Pawlax/Sterownik_rolety_zigbee/bom.pdf

bom

Page 1

Ref. | Wartość | Footprint | Ilość | Opis | Dostawca | Link | Koszt j.(1szt) | Cena (1 PCB) | Koszt j.(10szt) | Cena (10 PCB) | Koszt j.(100szt) | Cena (100 PCB)
C1 | 4.7uF | Capacitor_SMD:C_0603_1608Metric_Pad1.08x0.95mm_HandSolder | 1 Unpolarized capacitor | Mouser | 0.65 zł | 0.65 zł | 0.20 zł | 1.98 zł | 0.17 zł | 16.80 zł
C2,C3,C6,C8,C9,C10,C12,C17 | 100nF | Capacitor_SMD:C_0603_1608Metric_Pad1.08x0.95mm_HandSolder | 8 Unpolarized capacitor | Zaikostore | 0.04 zł | 0.33 zł | 0.04 zł | 3.28 zł | 0.04 zł | 32.80 zł
C4 | 470nF | Capacitor_SMD:C_0603_1608Metric_Pad1.08x0.95mm_HandSolder | 1 Unpolarized capacitor | Mouser | 0.57 zł | 0.57 zł | 0.23 zł | 2.28 zł | 0.15 zł | 14.60 zł
C5,C16 | 1uF | Capacitor_SMD:C_0603_1608Metric_Pad1.08x0.95mm_HandSolder | 2 Unpolarized capacitor | DigiKey | 0.41 zł | 0.82 zł | 0.09 zł | 1.82 zł | 0.06 zł | 12.40 zł
C7 | 10uF | Capacitor_SMD:C_0603_1608Metric_Pad1.08x0.95mm_HandSolder | 1 Unpolarized capacitor | DigiKey | 0.41 zł | 0.41 zł | 0.13 zł | 1.30 zł | 0.09 zł | 8.90 zł
C11 | 0.8pF | Capacitor_SMD:C_0603_1608Metric_Pad1.08x0.95mm_HandSolder | 1 Unpolarized capacitor | Mouser | 0.697 | 0.70 zł | 0.452 | 4.52 zł | 0.228 | 22.80 zł
C13,C14 | 16pF | Capacitor_SMD:C_0603_1608Metric_Pad1.08x0.95mm_HandSolder | 2 Unpolarized capacitor | Esaler Electronic | 0.12 zł | 0.24 zł | 0.12 zł | 2.40 zł | 0.12 zł | 24.00 zł
C15 | 0.3pF | Capacitor_SMD:C_0603_1608Metric_Pad1.08x0.95mm_HandSolder | 1 Unpolarized capacitor | DigiKey | 0.60 zł | 0.60 zł | 0.35 zł | 3.50 zł | 0.25 zł | 25.00 zł
D1,D2 | LED_Red | LED_SMD:LED_0603_1608Metric_Pad1.05x0.95mm_HandSolder | 2 Light emitting diode, filled shape | Mouser | 0.86 zł | 1.72 zł | 0.40 zł | 8.00 zł | 0.20 zł | 40.40 zł
FL1 | DLF162500LT-5028A1 | Sterownik_roletyLibrary:DLF162500LT5028A1 | 1 Signal Conditioning LTCC LOW PASS FLTR 2400-2500MHz | Mouser | 1.96 zł | 1.96 zł | 1.85 zł | 18.50 zł | 1.74 zł | 174.00 zł
IC1 | STM32WBA54KGU6 | Sterownik_roletyLibrary:QFN50P500X500X60-33N-D | 1 Wireless Arm Cortex-M33 Trust Zone MCU with Zigbee | Mouser | 23.05 zł | 23.05 zł | 15.05 zł | 150.50 zł | 14.09 zł | 1,409.00 zł
J1 | 282836-5 | Sterownik_roletyLibrary:2828365 | 1 Header | Electrical Characteristics: Operating Voltage 300 VAC | | Mouser | 6.71 zł | 6.71 zł | 5.20 zł | 52.00 zł | 4.64 zł | 464.00 zł
J2 | 1725669 | Sterownik_roletyLibrary:1725669 | 1 PCB terminal block, nominal current: 6 A, rated voltage (III/2): 160 V | TME | 4.31 zł | 4.31 zł | 4.31 zł | 43.10 zł | 3.42 zł | 342.00 zł
J3 | 53398-0567 | Sterownik_roletyLibrary:533980567 | 1 Headers & Wire Housings 1.25 WTB WAFER 5Ckt | Mouser | 4.86 zł | 4.86 zł | 4.29 zł | 42.90 zł | 3.80 zł | 380.00 zł
L1 | 2.7nH | Inductor_SMD:L_0603_1608Metric_Pad1.05x0.95mm_HandSolder | 1 Inductor | Mouser | 0.41 zł | 0.41 zł | 0.15 zł | 1.51 zł | 0.15 zł | 15.10 zł
Q1,Q2 | BT136-600 | Package_TO_SOT_THT:TO-220-3_Vertical | 2 4A RMS, 500V Off-State Voltage, Triac, TO-220 | AVT | 1.80 zł | 3.60 zł | 1.80 zł | 36.00 zł | 1.80 zł | 360.00 zł
Q3,Q4 | MOC3032SR2M | Package_DIP:DIP-6_W8.89mm_SMDSocket_LongPads | 2 Optotriac | Mouser | 2.07 zł | 4.14 zł | 1.95 zł | 39.00 zł | 1.91 zł | 382.00 zł
R1,R2,R3,R4 | 180R | Resistor_SMD:R_0603_1608Metric_Pad0.98x0.95mm_HandSolder | 4 Resistor | Mouser | 0.46 zł | 1.86 zł | 0.05 zł | 2.08 zł | 0.01 zł | 5.20 zł
R5,R6 | 330R | Resistor_SMD:R_0603_1608Metric_Pad0.98x0.95mm_HandSolder | 2 Resistor | TME | 0.37 zł | 0.73 zł | 0.04 zł | 0.79 zł | 0.02 zł | 4.66 zł
U1,U2 | LTV-817 | Package_DIP:DIP-4_W7.62mm | 2 DC Optocoupler, Vce 35V, CTR 50%, DIP-4 | Mouser | 1.72 zł | 3.44 zł | 1.01 zł | 20.20 zł | 0.50 zł | 100.60 zł
PS1 | RAC05-3.3SK | Converter_ACDC:Converter_ACDC_RECOM_RAC05-xxSK_THT | 1 5W Single Output EMC Class B 3.3V 1515mA | Mouser | 46.87 zł | 46.87 zł | 46.18 zł | 461.80 zł | 40.38 zł | 4,038.00 zł
Y1 | TXC 7R-32.000MEEV-T | Sterownik_roletyLibrary:TXC 7R-32.000MEEV-T | 1 Four pin crystal, GND on pins 2 and 4 | Digikey | 2.52 zł | 2.52 zł | 2.18 zł | 21.80 zł | 1.97 zł | 197.00 zł
| | | | | | | 1 PCB | | 10 PCB | | 100 PCB
| | | | | | Łącznie | Za sztukę | Łącznie | Za sztukę | Łącznie | Za sztukę
| | | | | Łączny koszt kompnentów | 110.50 zł | 110.50 zł | 919.26 zł | 91.93 zł | 8,069.26 zł | 80.69 zł
Produkcja PCB | 8.29 zł | 8.29 zł | 20.71 zł | 2.07 zł | 81.98 zł | 0.82 zł
| | | | | Suma | 118.79 zł | 118.79 zł | 939.97 zł | 94.00 zł | 8,151.24 zł | 81.51 zł

link (https://www.mouser.pl/ProductDetail/Murata-Electronics/GRM188R61E475KE11D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)
link (https://www.zaikostore.com/zaikostore/en/stockDetail?stockID=st64811696)
link (https://www.mouser.pl/ProductDetail/Murata-Electronics/GRM188R71E474KA12D?qs=5VWgUag8BO05DbKPNL84bA%3D%3D)
link (https://www.digikey.com/en/products/detail/walsin-technology-corporation/0603B105K250CT/14837019?curr=usd)
link (https://www.digikey.com/en/products/detail/walsin-technology-corporation/0603X106M6R3CT/14830826?curr=usd)
link (https://www.mouser.pl/ProductDetail/Murata-Electronics/GCM1885C2AR80BA16J)
link (https://www.elecsaler.com/product/murata/gcm1885c2a160fa16d-11236865)
link (https://www.digikey.bg/en/products/detail/murata-electronics/GJM1555C1HR30WB01D/2593245)
link (https://www.mouser.pl/ProductDetail/Lite-On/LTST-C190KRKT?qs=kAD5fFa1n5VY3YYNWPC1Fg%3D%3D)
link (https://www.mouser.pl/ProductDetail/TDK/DLF162500LT-5028A1?qs=U%2FZX79kHR%2FlwIbAISCs3qA%3D%3D)
link (https://www.mouser.pl/ProductDetail/STMicroelectronics/STM32WBA54KGU6?qs=Z%252BL2brAPG1JAa6VTqSppyg%3D%3D)
link (https://www.mouser.pl/ProductDetail/TE-Connectivity/282836-5?qs=A%252Bip%252BNCYi6PWM9nOrDokEg%3D%3D)
link (https://www.tme.eu/pl/details/mpt0.5_3-2.54/listwy-zaciskowe-do-druku/phoenix-contact/1725669/?gad_source=1)
link (https://www.mouser.pl/ProductDetail/Molex/53398-0567?qs=YbyaSBbY%2FzyzhOKGMMuQvw%3D%3D)
link (https://www.mouser.pl/ProductDetail/KEMET/L0603C2N7SRMST?qs=v1sh8PPj49gJHURlIJB4QA%3D%3D)
link (https://sklep.avt.pl/pl/products/triak-bt136-600-kt207-500-164756.html)
link (https://eu.mouser.com/ProductDetail/onsemi-Fairchild/MOC3032SR2M?qs=Q3c8oR7VdSoN0Us1kztB%2FQ%3D%3D)
link (https://www.mouser.pl/ProductDetail/Walsin/WR06X1800FTL?qs=t1sE%252BOcWp5ujA9Z8%2FbuwQg%3D%3D)
link (https://www.tme.eu/pl/en/details/wr06x331jtl/smd-resistors/walsin/wr06x331-jtl/)
link (https://www.mouser.pl/ProductDetail/Lite-On/LTV-817?qs=N6LLV8I65%252BeGRLHZiOxD6A%3D%3D)
link (https://www.mouser.pl/ProductDetail/RECOM-Power/RAC05-3.3SK?qs=BZBei1rCqCCc2PDPqoMlxw%3D%3D)
link (https://www.digikey.gr/en/products/detail/txc-corporation/7R-32-000MEEV-T/12314103)
A | B | C | D | E | F | G | H | I | J | K | L | M
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
