Pawlax/Sterownik_rolety_zigbee/sterownik_rolety_Zigbee.pdf

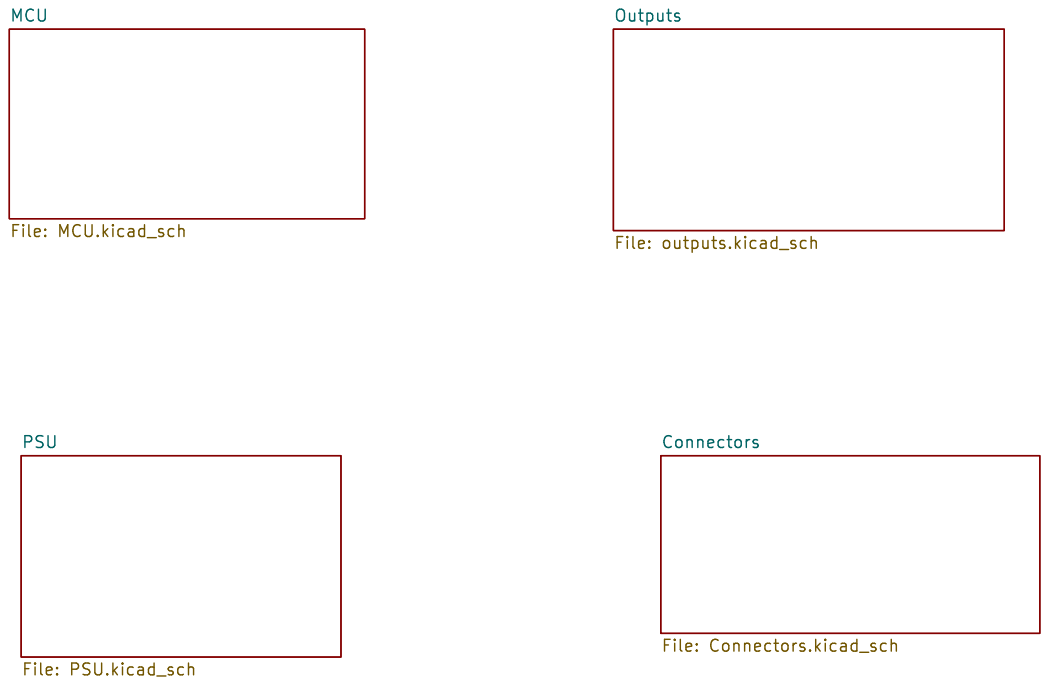
[picture p1: page 1]

Id: 1/5 Title: sterownik rolety z þÿkomunikacj zigbee

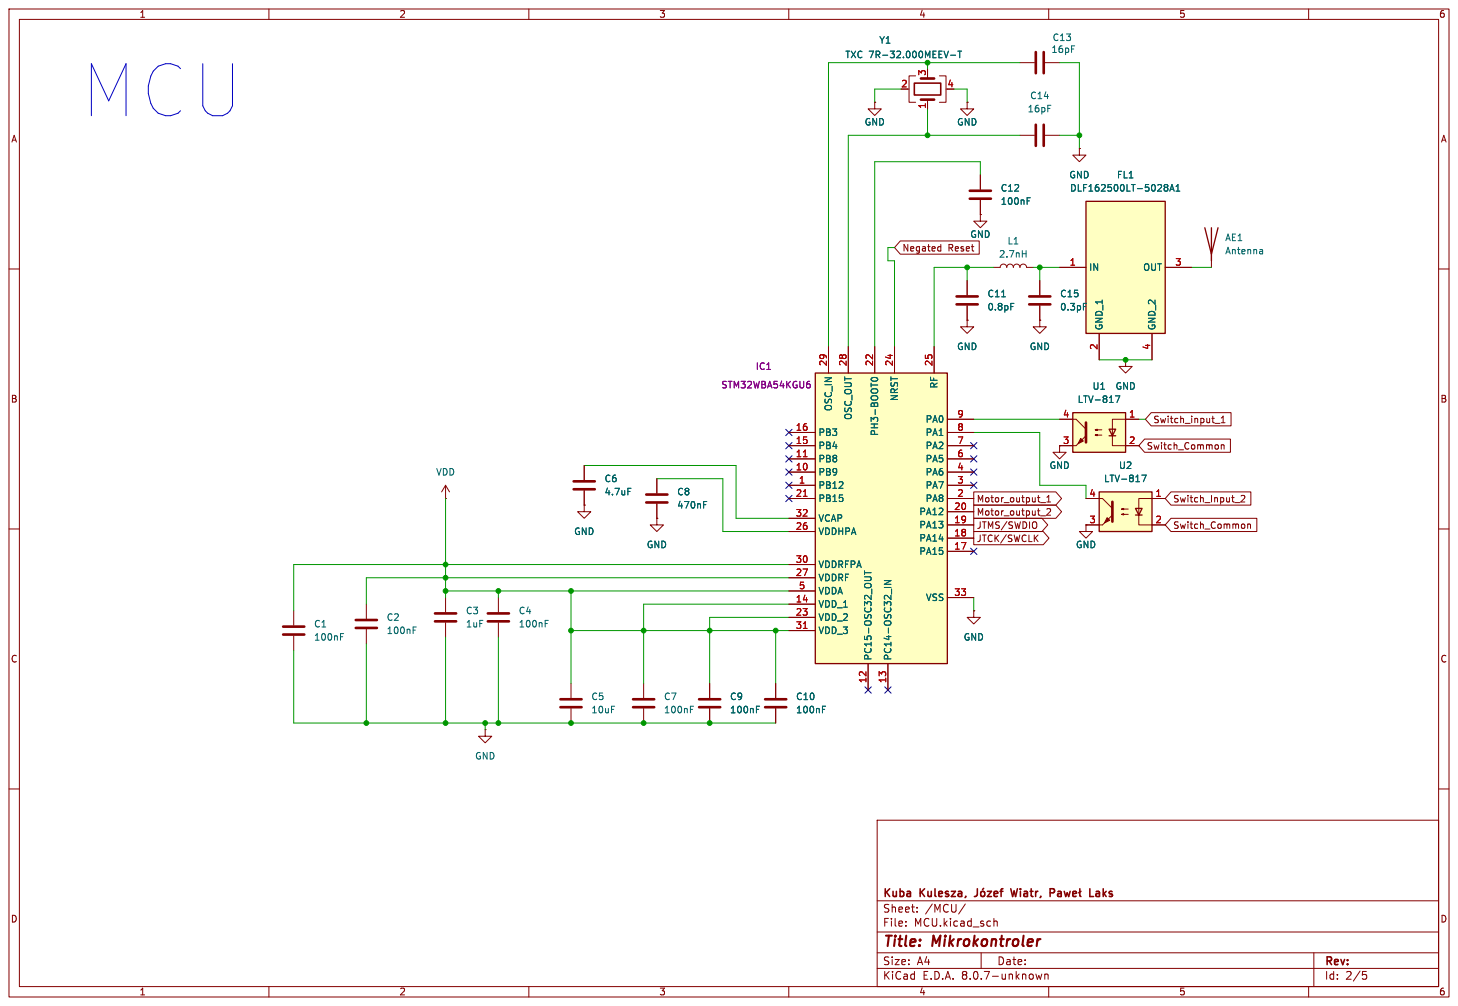
[picture p2: page 2]

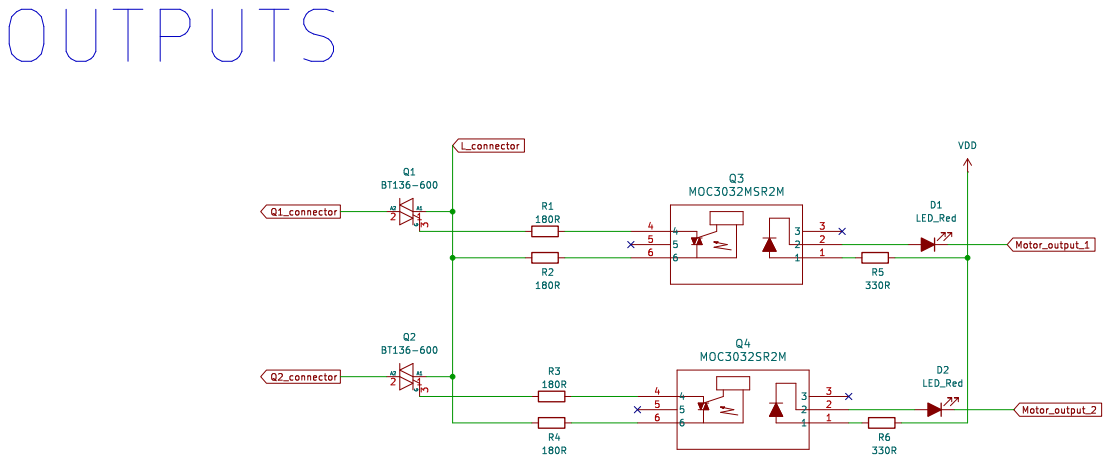
[picture p3: page 3]

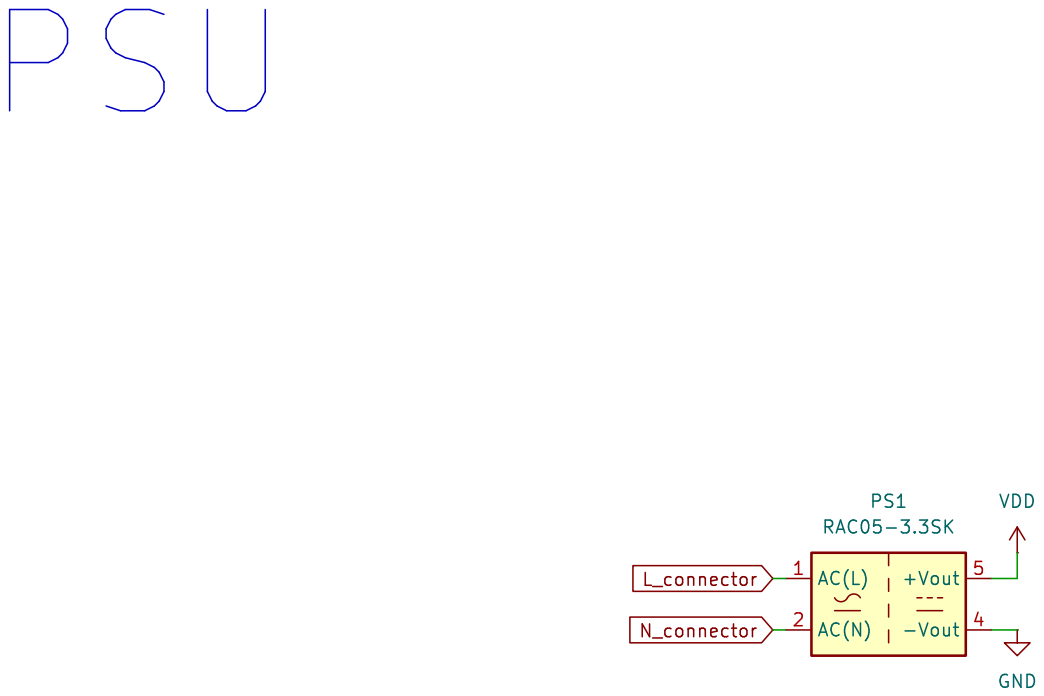
[picture p4: page 4]

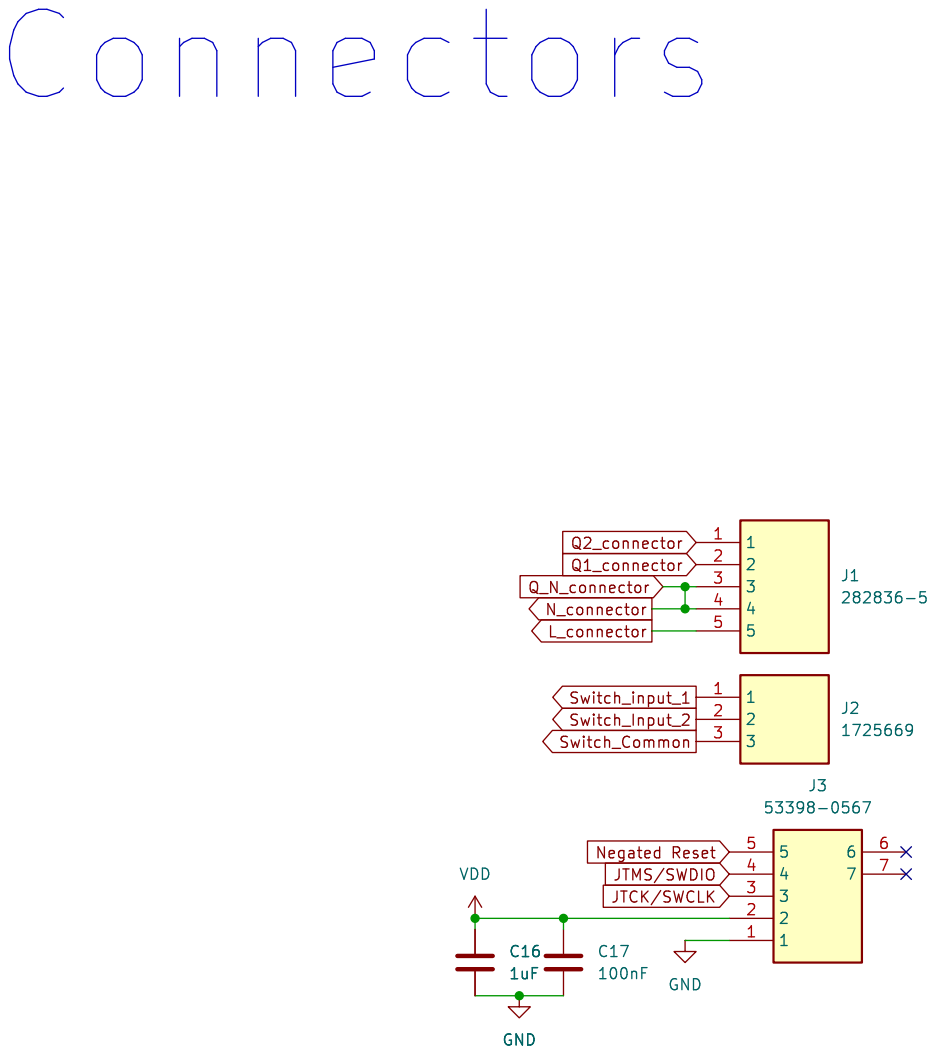
[picture p5: page 5]

L_connector Switch_Common Switch_input_1 Q_N_connector Negated Reset JTMS/SWDIO
