Pawlax/Sterownik_rolety_zigbee/sterownik_rolety_Zigbee.kicad_pcb

## KiCad design sterownik_rolety_Zigbee.kicad_pcb (2025-01-05)

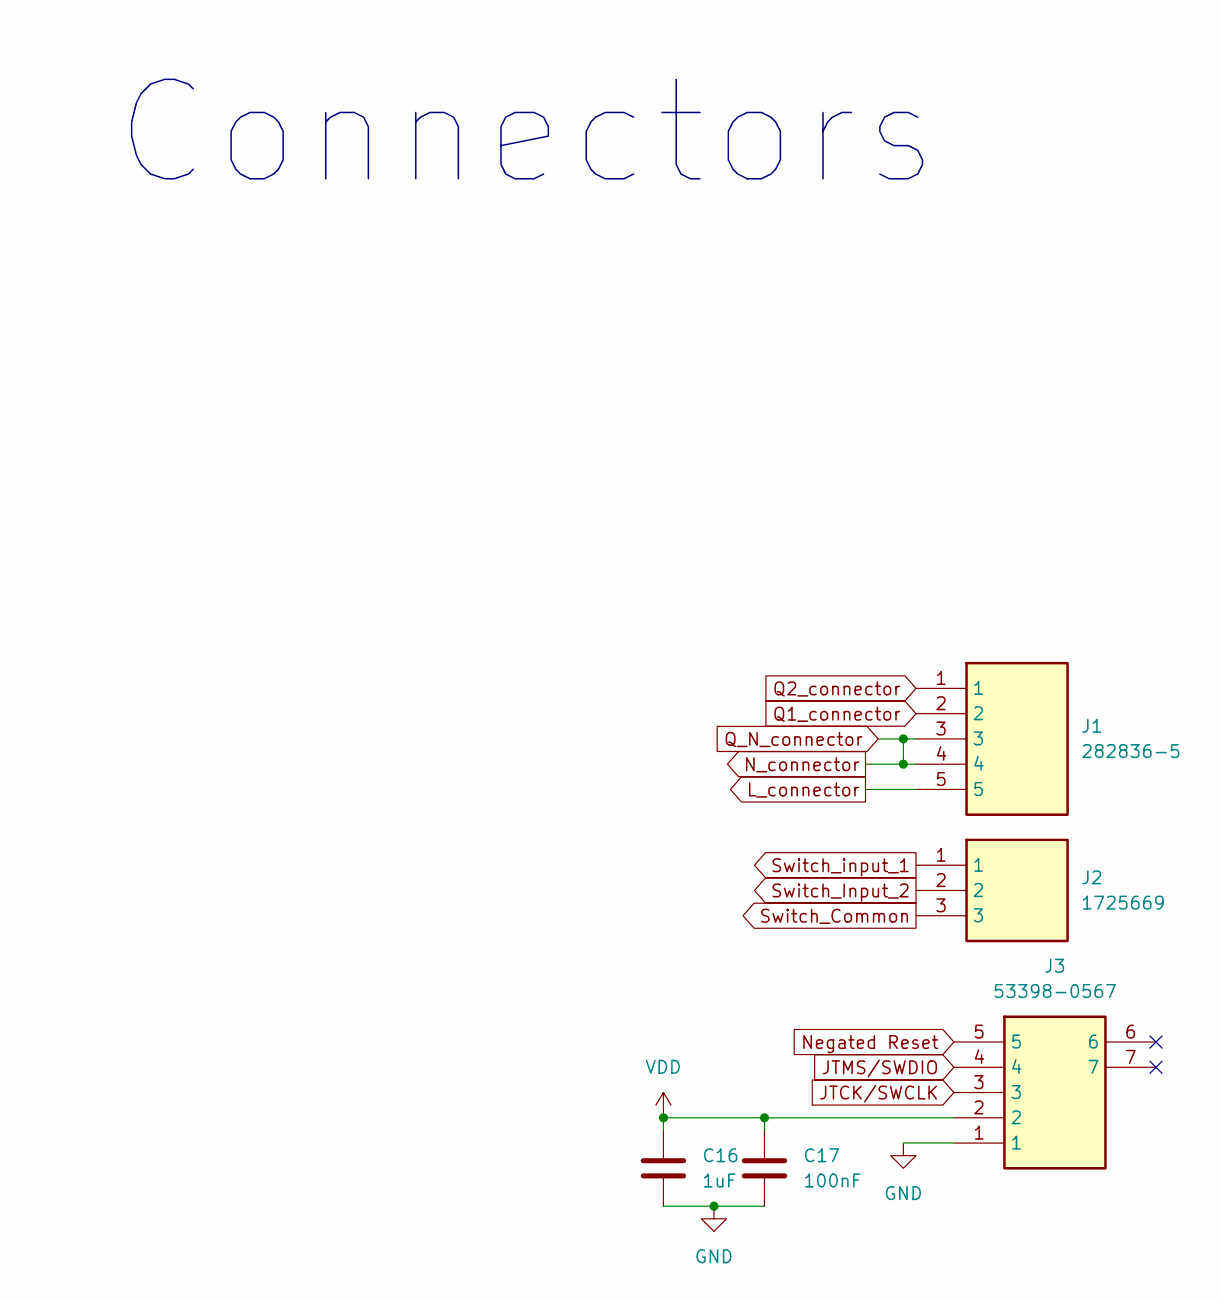
[picture p6: schematic Connectors.kicad_sch, Złącza]

Parts:
C16: 1uF; C_0603_1608Metric_Pad1.08x0.95mm_HandSolder
C17: 100nF; C_0603_1608Metric_Pad1.08x0.95mm_HandSolder
J1: 282836-5; 2828365; Mouser Part Number 571-2828365
J2: 1725669; Mouser Part Number 651-1725669
J3: 53398-0567; 533980567; Mouser Part Number 538-53398-0567

Connections:
GND: C16.2, C17.2, J3.1; also elsewhere on the board
JTCK/SWCLK: J3.3; also elsewhere on the board
JTMS/SWDIO: J3.4; also elsewhere on the board
L_connector: J1.5; also elsewhere on the board
N_connector: J1.3, J1.4; also elsewhere on the board
Negated Reset: J3.5; also elsewhere on the board
Q1_connector: J1.2; also elsewhere on the board
Q2_connector: J1.1; also elsewhere on the board
Switch_Common: J2.3; also elsewhere on the board
Switch_Input_2: J2.2; also elsewhere on the board
Switch_input_1: J2.1; also elsewhere on the board
VDD: C16.1, C17.1, J3.2; also elsewhere on the board

Notes on the sheet:
Connectors

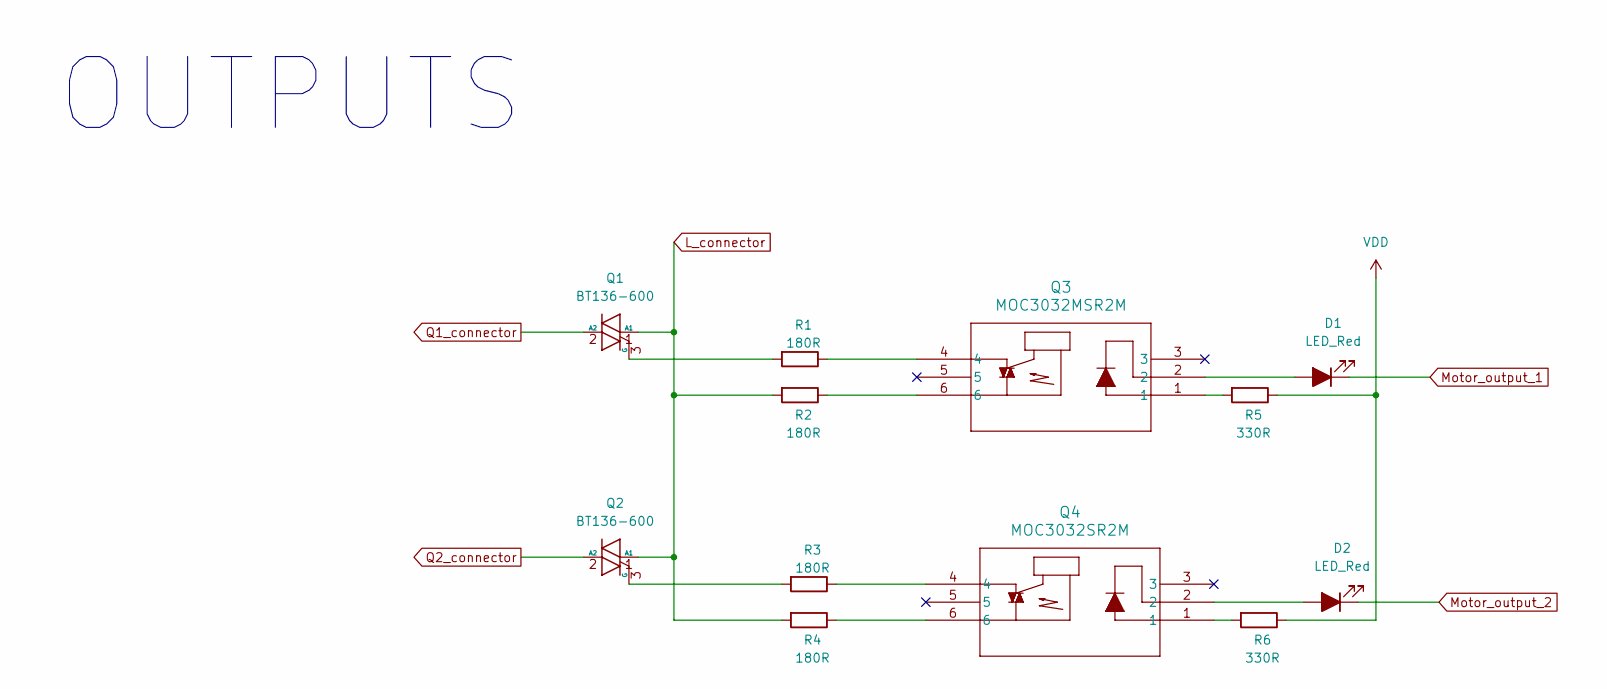
[picture p7: schematic outputs.kicad_sch, Wyjścia]

Parts:
D1, D2: LED_Red; LED_0603_1608Metric_Pad1.05x0.95mm_HandSolder
Q1, Q2: BT136-600; TO-220-3_Vertical
Q3: MOC3032MSR2M; DIP-6_W8.89mm_SMDSocket_LongPads
Q4: MOC3032SR2M; DIP-6_W8.89mm_SMDSocket_LongPads
R1, R2, R3, R4: 180R; R_0603_1608Metric_Pad0.98x0.95mm_HandSolder
R5, R6: 330R; R_0603_1608Metric_Pad0.98x0.95mm_HandSolder

Connections:
L_connector: Q1.1 (A1), Q2.1 (A1), R2.2, R4.2; also elsewhere on the board
Motor_output_1: D1.1 (K); also elsewhere on the board
Motor_output_2: D2.1 (K); also elsewhere on the board
unnamed: D1.2 (A), Q3.2
unnamed: D2.2 (A), Q4.2
unnamed: Q1.3 (G), R1.2
unnamed: Q2.3 (G), R3.2
unnamed: Q3.1, R5.2
unnamed: Q3.4, R1.1
unnamed: Q3.6, R2.1
unnamed: Q4.1, R6.2
unnamed: Q4.4, R3.1
unnamed: Q4.6, R4.1
Q1_connector: Q1.2 (A2); also elsewhere on the board
Q2_connector: Q2.2 (A2); also elsewhere on the board
VDD: R5.1, R6.1; also elsewhere on the board

Notes on the sheet:
OUTPUTS

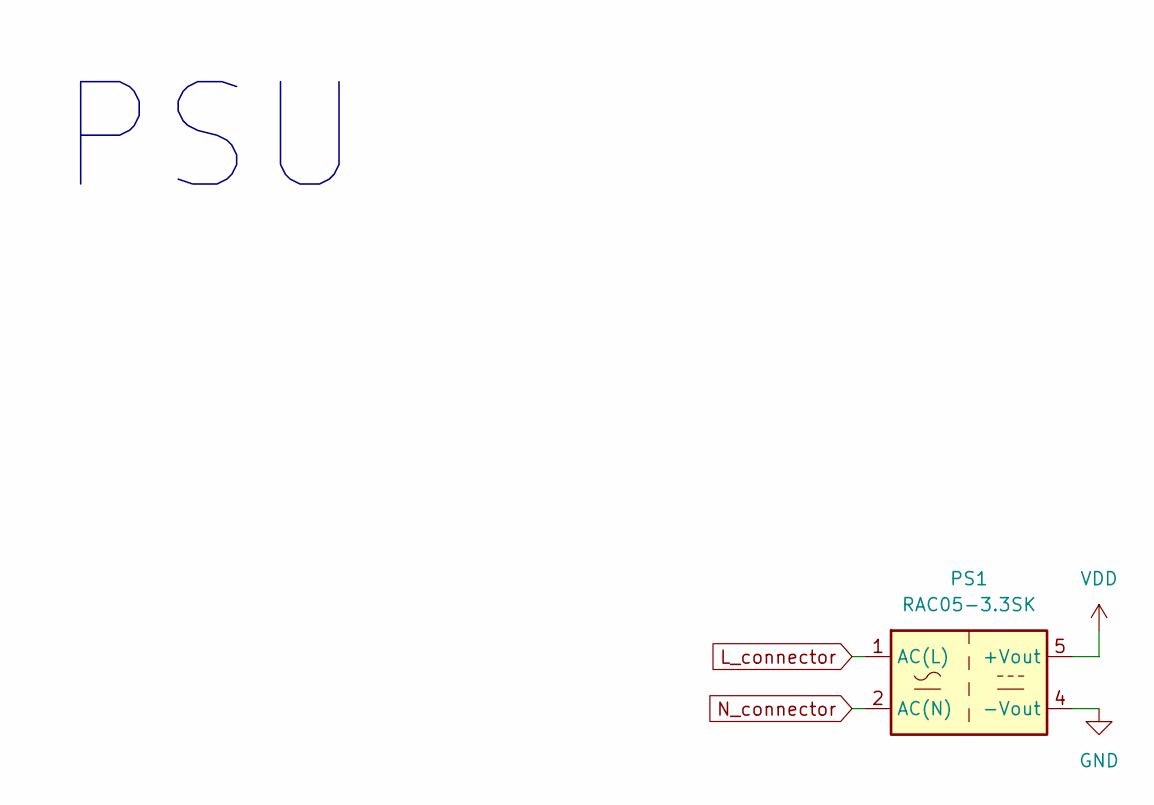
[picture p8: schematic PSU.kicad_sch, Zasilanie]

Parts:
PS1: RAC05-3.3SK; Converter_ACDC_RECOM_RAC05-xxSK_THT

Connections:
GND: PS1.4 (-Vout); also elsewhere on the board
L_connector: PS1.1 (AC(L)); also elsewhere on the board
N_connector: PS1.2 (AC(N)); also elsewhere on the board
VDD: PS1.5 (+Vout); also elsewhere on the board

Notes on the sheet:
PSU

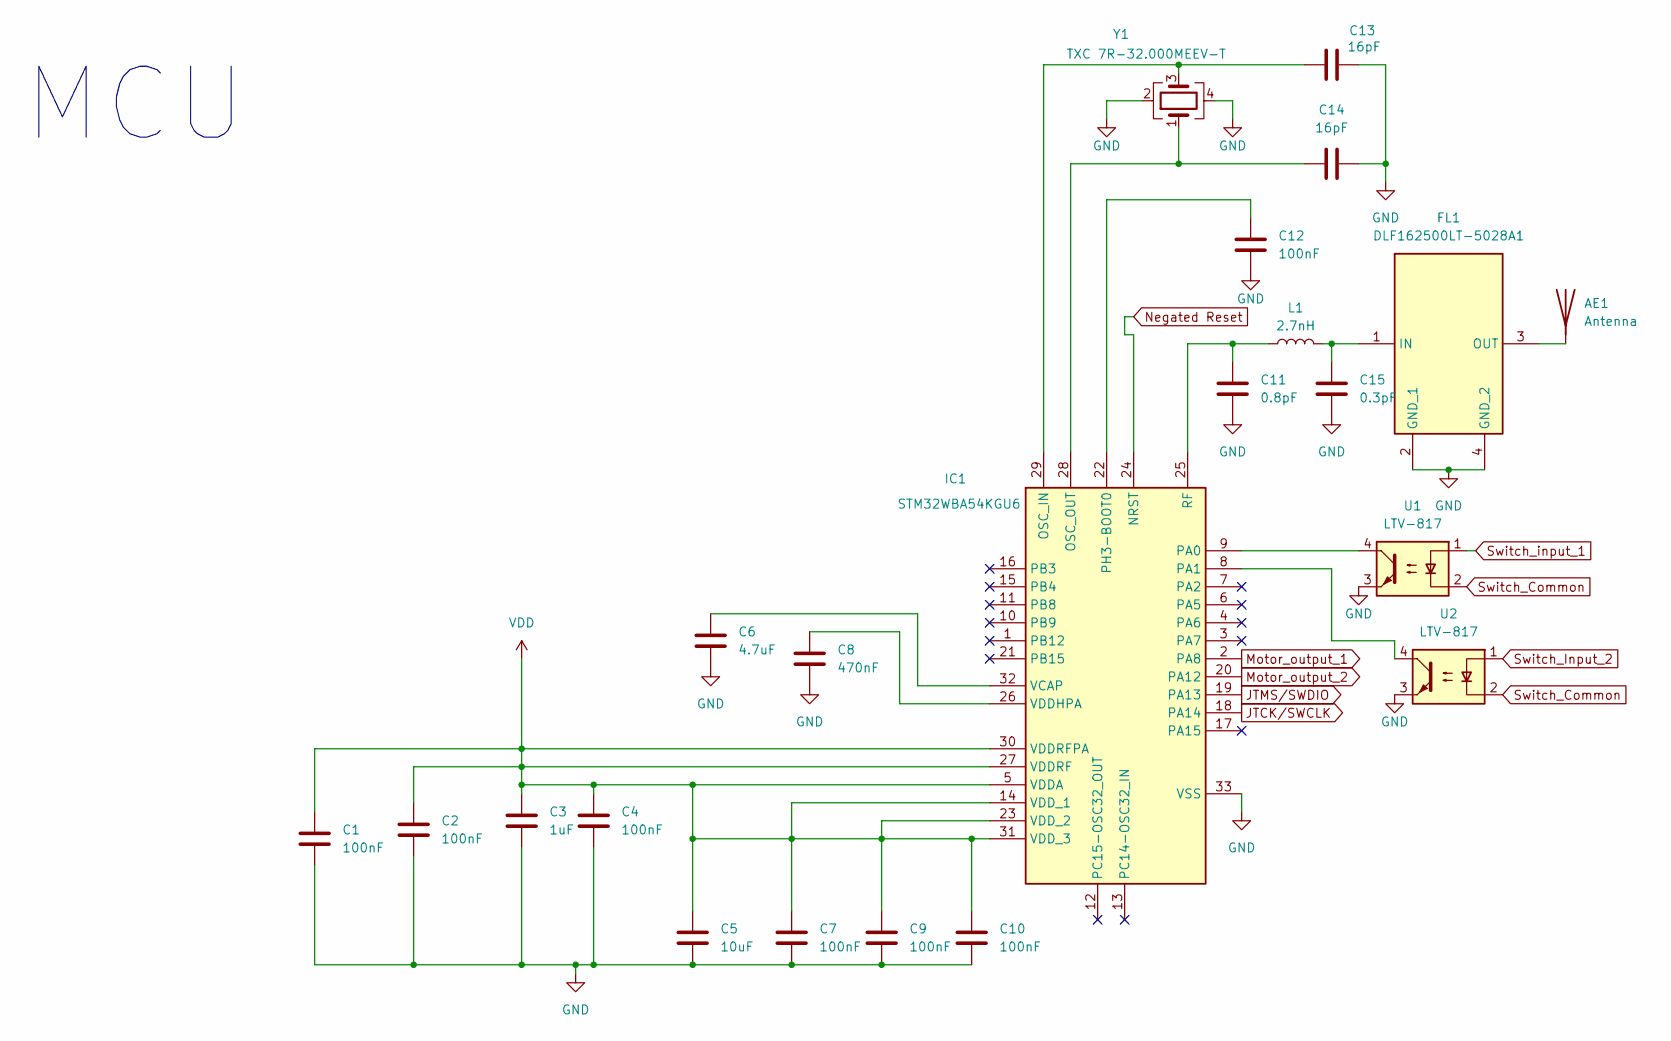
[picture p9: schematic MCU.kicad_sch, Mikrokontroler]

Parts:
AE1: Antenna; Texas_SWRA117D_2.4GHz_Right
C1, C2, C4, C7, C9, C10, C12: 100nF; C_0603_1608Metric_Pad1.08x0.95mm_HandSolder
C3: 1uF; C_0603_1608Metric_Pad1.08x0.95mm_HandSolder
C5: 10uF; C_0603_1608Metric_Pad1.08x0.95mm_HandSolder
C6: 4.7uF; C_0603_1608Metric_Pad1.08x0.95mm_HandSolder
C8: 470nF; C_0603_1608Metric_Pad1.08x0.95mm_HandSolder
C11: 0.8pF; C_0603_1608Metric_Pad1.08x0.95mm_HandSolder
C13, C14: 16pF; C_0603_1608Metric_Pad1.08x0.95mm_HandSolder
C15: 0.3pF; C_0603_1608Metric_Pad1.08x0.95mm_HandSolder
FL1: DLF162500LT-5028A1; DLF162500LT5028A1; Mouser Part Number 810-DLF16250LT5028A1
IC1: STM32WBA54KGU6; QFN50P500X500X60-33N-D; Mouser Part Number 511-STM32WBA54KGU6
L1: 2.7nH; L_0603_1608Metric_Pad1.05x0.95mm_HandSolder
U1, U2: LTV-817; SMDIP-4_W9.53mm
Y1: TXC 7R-32.000MEEV-T

Connections:
GND: C1.2, C2.2, C3.2, C4.2, C5.2, C6.2, C7.2, C8.2, C9.2, C10.2, C11.2, C12.2, C13.1, C14.1, C15.2, FL1.2 (GND_1), FL1.4 (GND_2), IC1.33 (VSS), U1.3, U2.3, Y1.2, Y1.4; also elsewhere on the board
JTCK/SWCLK: IC1.18 (PA14); also elsewhere on the board
JTMS/SWDIO: IC1.19 (PA13); also elsewhere on the board
Motor_output_1: IC1.2 (PA8); also elsewhere on the board
Motor_output_2: IC1.20 (PA12); also elsewhere on the board
Negated Reset: IC1.24 (NRST); also elsewhere on the board
unnamed: AE1.1 (A), FL1.3 (OUT)
unnamed: C15.1, FL1.1 (IN), L1.2
unnamed: C13.2, IC1.29 (OSC_IN), Y1.3
unnamed: C14.2, IC1.28 (OSC_OUT), Y1.1
unnamed: IC1.9 (PA0), U1.4
unnamed: IC1.8 (PA1), U2.4
unnamed: C12.1, IC1.22 (PH3-BOOT0)
unnamed: C11.1, IC1.25 (RF), L1.1
unnamed: C6.1, IC1.32 (VCAP)
unnamed: C8.1, IC1.26 (VDDHPA)
Switch_Common: U1.2, U2.2; also elsewhere on the board
Switch_Input_2: U2.1; also elsewhere on the board
Switch_input_1: U1.1; also elsewhere on the board
VDD: C1.1, C2.1, C3.1, C4.1, C5.1, C7.1, C9.1, C10.1, IC1.5 (VDDA), IC1.14 (VDD_1), IC1.23 (VDD_2), IC1.27 (VDDRF), IC1.30 (VDDRFPA), IC1.31 (VDD_3); also elsewhere on the board

Notes on the sheet:
MCU

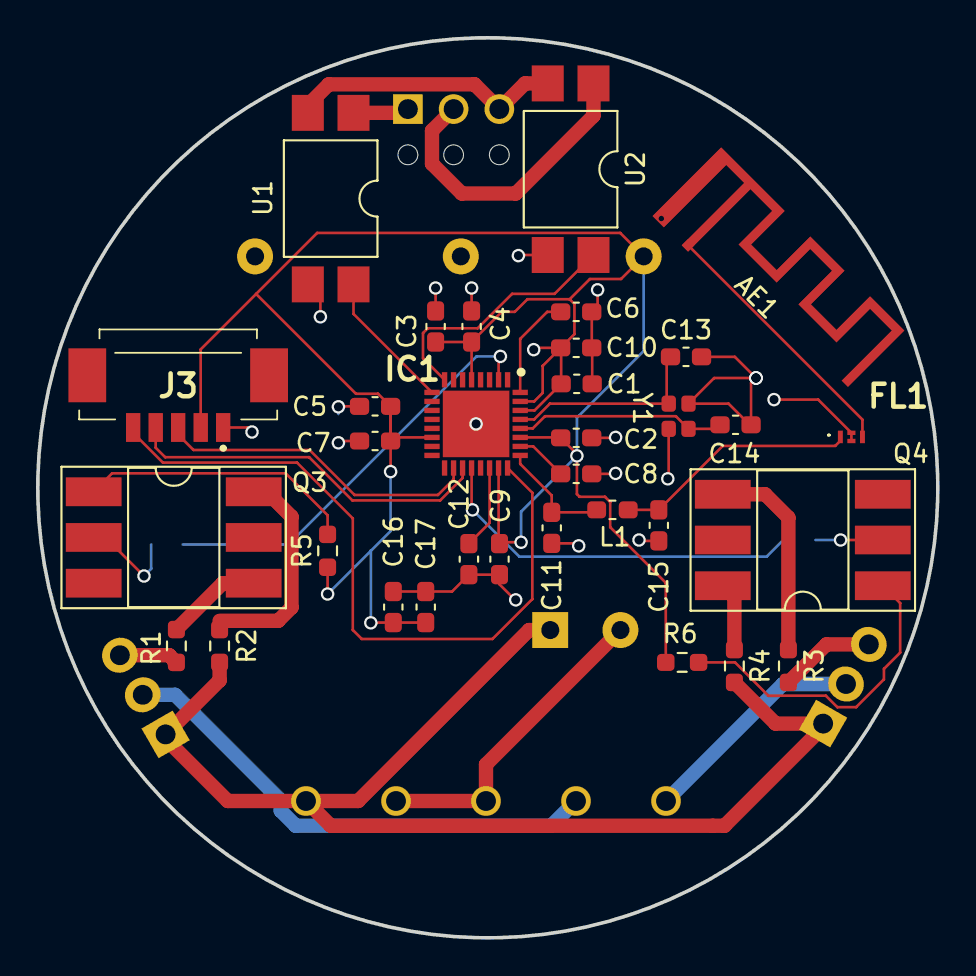
[picture p10: board sterownik_rolety_Zigbee.kicad_pcb from above]

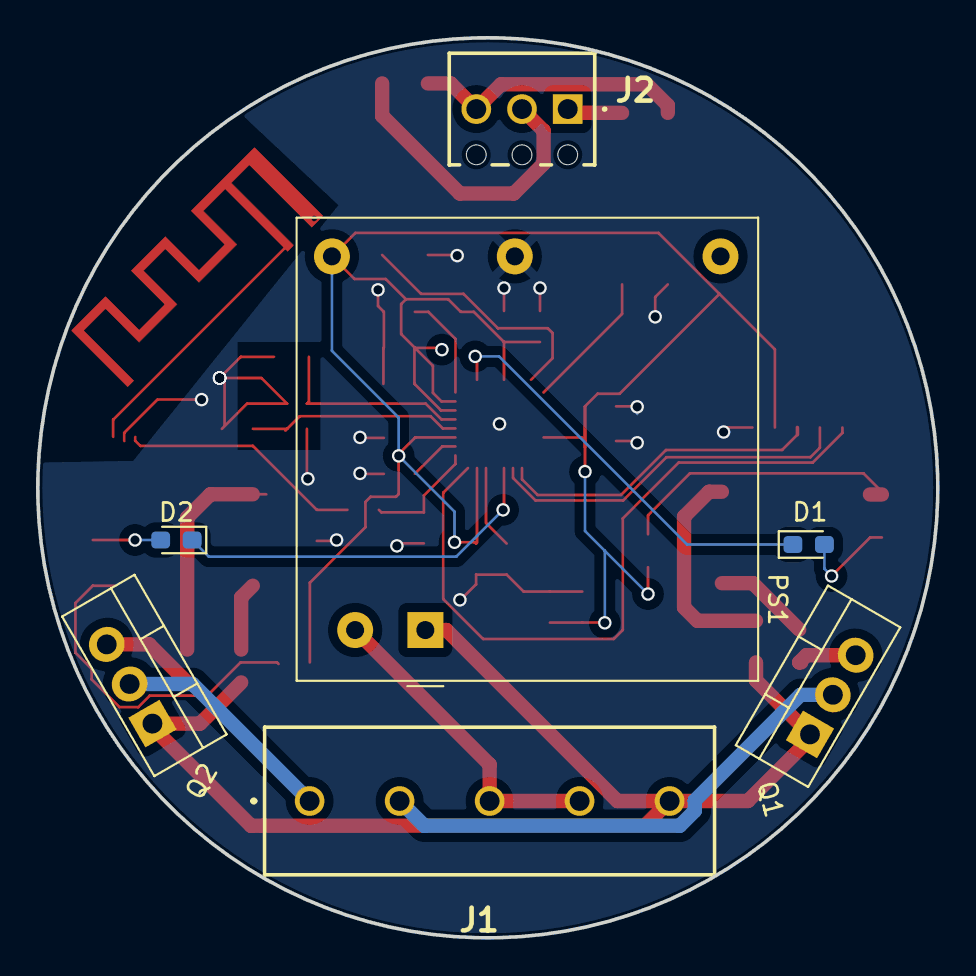
[picture p11: board sterownik_rolety_Zigbee.kicad_pcb from below]

Board: 2 copper layers, 50.0 x 50.0 mm, 40 parts (7 on the bottom side), 34 nets.
