Pawlax/Sterownik_rolety_zigbee/(commit log)

2024-12-11 kryształ kondensatory i interfejs podłączone z mikrokontrolerem
    [sterownik_rolety_Zigbee.kicad_pcb]
2024-12-30 połączenie ścieżkami, wylanie masy
    [Connectors.kicad_sch, MCU.kicad_sch, outputs.kicad_sch, sterownik_rolety_Zigbee.kicad_pcb]
2025-01-04 BOM Gerbery, schemat w pdfie i zip do oddania na razie bez wszystkich numerów indeksu
    [Connectors.kicad_sch, MCU.kicad_sch, PSU.kicad_sch, bom.ods, outputs.kicad_sch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]
2025-01-05 poprawka wymiaru płytki
    [Connectors.kicad_sch, MCU.kicad_sch, PSU.kicad_sch, outputs.kicad_sch, sterownik_rolety_Zigbee.kicad_pcb]
2025-01-05 Wersja finalna
    [sterownik_rolety_Zigbee.kicad_pcb]
2025-01-05 BOM Gerbery, schemat w pdfie i zip do oddanie bez jednego numeru indeksu
    [bom.ods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]
